yusufozkann/stm32-gemstone-gimbal-tracker/ServoKontrol.ioc

Mcu.UserName=STM32G431RBTx
PA0.Signal=S_TIM2_CH1
PA1.Signal=S_TIM2_CH2
PA2.Signal=LPUART1_TX
PA3.Signal=LPUART1_RX
