yusufozkann/stm32-gemstone-gimbal-tracker/(commit log)

2026-10-24 Servo PWM control and interrupt-driven UART command interface
2026-10-25 Add tilt servo on TIM2_CH2 with external 5V power supply
2026-10-25 Add two-axis UART protocol (P<angle>,T<angle>)
2026-10-25 Add PID tracking loop with simulated camera (50 Hz)
2026-10-25 Add runtime Kp tuning over UART (K command)
2026-10-31 Add camera-driven PID tracking (C/N commands) and first pan tracking demo
